daambien/scale-based-midi-controller/kicad/kb_pcb.kicad_pcb

## KiCad design kicad/kb_pcb.kicad_pcb (2022-11-20)

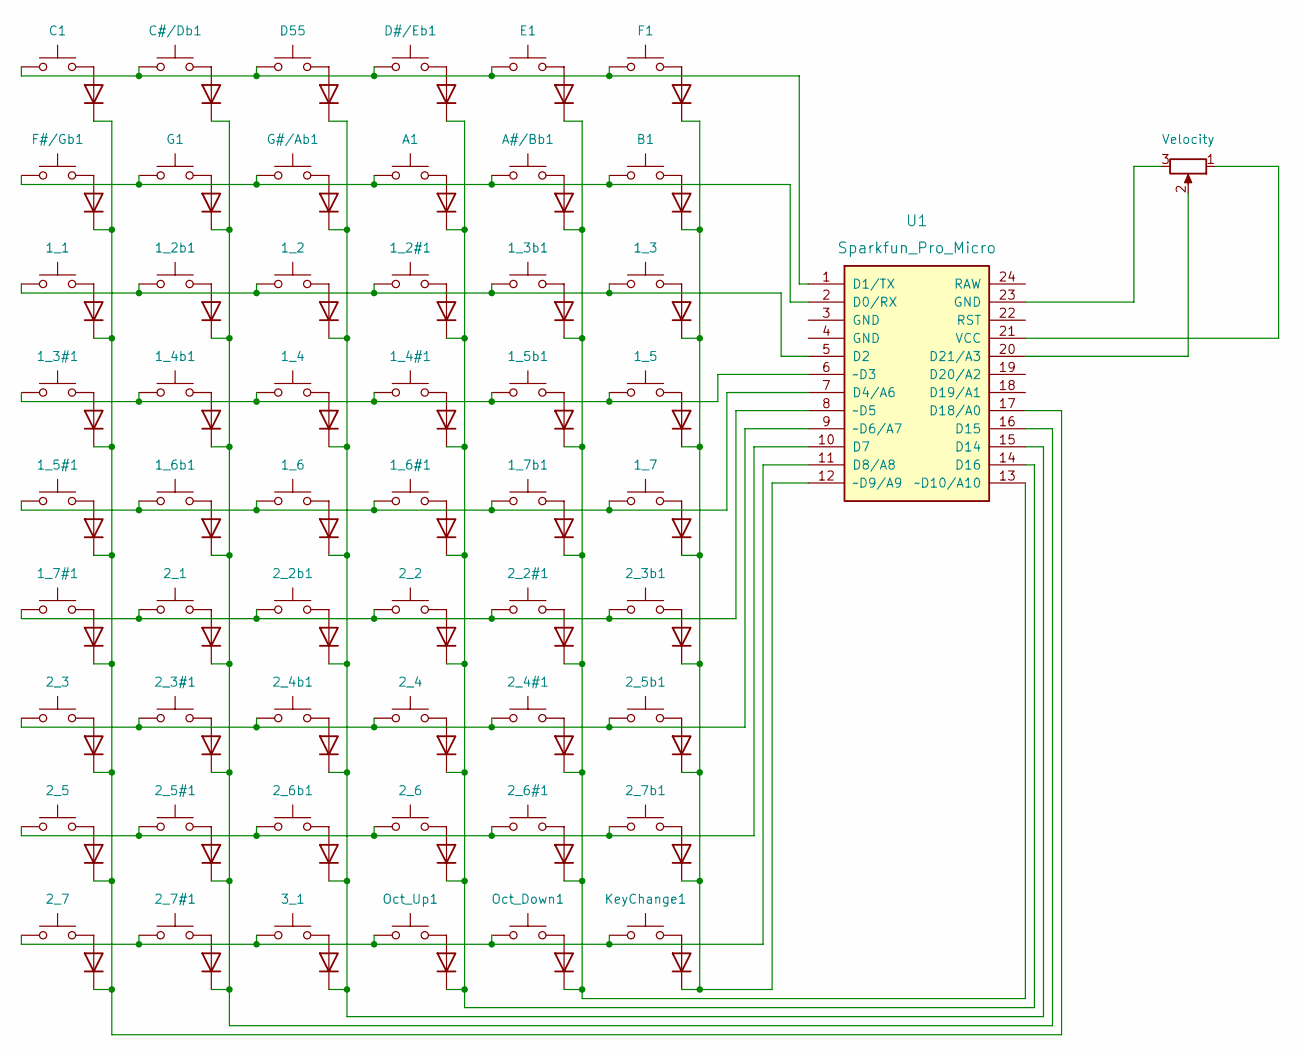
[picture p1: schematic kb_pcb.kicad_sch, MIDI_Keyboard]

Parts:
1_1, 1_2, 1_2#1, 1_2b1, 1_3, 1_3#1, 1_3b1, 1_4, 1_4#1, 1_4b1, 1_5, 1_5#1, 1_5b1, 1_6, 1_6#1, 1_6b1, 1_7, 1_7#1, 1_7b1, 2_1, 2_2, 2_2#1, 2_2b1, 2_3, 2_3#1, 2_3b1, 2_4, 2_4#1, 2_4b1, 2_5, 2_5#1, 2_5b1, 2_6, 2_6#1, 2_6b1, 2_7, 2_7#1, 2_7b1, 3_1: SW_Push; SW_Cherry_MX_1.00u_Plate
A1: SW_Push; SW_Cherry_MX_1.00u_Plate
A#/Bb1: SW_Push; SW_Cherry_MX_1.00u_Plate
B1: SW_Push; SW_Cherry_MX_1.00u_Plate
C1: SW_Push; SW_Cherry_MX_1.00u_Plate
C#/Db1: SW_Push; SW_Cherry_MX_1.00u_Plate
D1, D2, D3, D4, D5, D6, D7, D8, D9, D10, D11, D12, D13, D14, D15, D16, D17, D18, D19, D20, D21, D22, D23, D24, D25, D26, D27, D28, D29, D30, D31, D32, D33, D34, D35, D36, D37, D38, D39, D40, D41, D42, D43, D44, D45, D46, D47, D48, D49, D50, D51, D52, D53, D54: 1N4148; D_DO-35_SOD27_P7.62mm_Horizontal
D55: SW_Push; SW_Cherry_MX_1.00u_Plate
D#/Eb1: SW_Push; SW_Cherry_MX_1.00u_Plate
E1: SW_Push; SW_Cherry_MX_1.00u_Plate
F1: SW_Push; SW_Cherry_MX_1.00u_Plate
F#/Gb1: SW_Push; SW_Cherry_MX_1.00u_Plate
G1: SW_Push; SW_Cherry_MX_1.00u_Plate
G#/Ab1: SW_Push; SW_Cherry_MX_1.00u_Plate
KeyChange1: SW_Push; SW_Cherry_MX_1.00u_Plate
Oct_Down1: SW_Push; SW_Cherry_MX_1.00u_Plate
Oct_Up1: SW_Push; SW_Cherry_MX_1.00u_Plate
RV1: Velocity
U1: Sparkfun_Pro_Micro

Connections:
unnamed: 1_1.1, 1_2.1, 1_2#1.1, 1_2b1.1, 1_3.1, 1_3b1.1, U1.5 (D2)
unnamed: 1_1.2, D3.2 (A)
unnamed: 1_2#1.2, D30.2 (A)
unnamed: 1_2.2, D21.2 (A)
unnamed: 1_2b1.2, D12.2 (A)
unnamed: 1_3#1.1, 1_4.1, 1_4#1.1, 1_4b1.1, 1_5.1, 1_5b1.1, U1.6 (~D3)
unnamed: 1_3#1.2, D4.2 (A)
unnamed: 1_3.2, D48.2 (A)
unnamed: 1_3b1.2, D39.2 (A)
unnamed: 1_4#1.2, D31.2 (A)
unnamed: 1_4.2, D22.2 (A)
unnamed: 1_4b1.2, D13.2 (A)
unnamed: 1_5#1.1, 1_6.1, 1_6#1.1, 1_6b1.1, 1_7.1, 1_7b1.1, U1.7 (D4/A6)
unnamed: 1_5#1.2, D5.2 (A)
unnamed: 1_5.2, D49.2 (A)
unnamed: 1_5b1.2, D40.2 (A)
unnamed: 1_6#1.2, D32.2 (A)
unnamed: 1_6.2, D23.2 (A)
unnamed: 1_6b1.2, D14.2 (A)
unnamed: 1_7#1.1, 2_1.1, 2_2.1, 2_2#1.1, 2_2b1.1, 2_3b1.1, U1.8 (~D5)
unnamed: 1_7#1.2, D6.2 (A)
unnamed: 1_7.2, D50.2 (A)
unnamed: 1_7b1.2, D41.2 (A)
unnamed: 2_1.2, D15.2 (A)
unnamed: 2_2#1.2, D42.2 (A)
unnamed: 2_2.2, D33.2 (A)
unnamed: 2_2b1.2, D24.2 (A)
unnamed: 2_3.1, 2_3#1.1, 2_4.1, 2_4#1.1, 2_4b1.1, 2_5b1.1, U1.9 (~D6/A7)
unnamed: 2_3#1.2, D16.2 (A)
unnamed: 2_3.2, D7.2 (A)
unnamed: 2_3b1.2, D51.2 (A)
unnamed: 2_4#1.2, D43.2 (A)
unnamed: 2_4.2, D34.2 (A)
unnamed: 2_4b1.2, D25.2 (A)
unnamed: 2_5.1, 2_5#1.1, 2_6.1, 2_6#1.1, 2_6b1.1, 2_7b1.1, U1.10 (D7)
unnamed: 2_5#1.2, D17.2 (A)
unnamed: 2_5.2, D8.2 (A)
unnamed: 2_5b1.2, D52.2 (A)
unnamed: 2_6#1.2, D44.2 (A)
unnamed: 2_6.2, D35.2 (A)
unnamed: 2_6b1.2, D26.2 (A)
unnamed: 2_7#1.2, D18.2 (A)
unnamed: 2_7.2, D9.2 (A)
unnamed: 2_7b1.2, D53.2 (A)
unnamed: 2_7.1, 2_7#1.1, 3_1.1, KeyChange1.1, Oct_Down1.1, Oct_Up1.1, U1.11 (D8/A8)
unnamed: 3_1.2, D27.2 (A)
unnamed: A1.2, D29.2 (A)
unnamed: A1.1, A#/Bb1.1, B1.1, F#/Gb1.1, G1.1, G#/Ab1.1, U1.2 (D0/RX)
unnamed: A#/Bb1.2, D38.2 (A)
unnamed: B1.2, D47.2 (A)
unnamed: C1.2, D1.2 (A)
unnamed: C1.1, C#/Db1.1, D55.1, D#/Eb1.1, E1.1, F1.1, U1.1 (D1/TX)
unnamed: C#/Db1.2, D10.2 (A)
unnamed: D1.1 (K), D2.1 (K), D3.1 (K), D4.1 (K), D5.1 (K), D6.1 (K), D7.1 (K), D8.1 (K), D9.1 (K), U1.17 (D18/A0)
unnamed: D10.1 (K), D11.1 (K), D12.1 (K), D13.1 (K), D14.1 (K), D15.1 (K), D16.1 (K), D17.1 (K), D18.1 (K), U1.16 (D15)
unnamed: D19.1 (K), D20.1 (K), D21.1 (K), D22.1 (K), D23.1 (K), D24.1 (K), D25.1 (K), D26.1 (K), D27.1 (K), U1.15 (D14)
unnamed: D28.1 (K), D29.1 (K), D30.1 (K), D31.1 (K), D32.1 (K), D33.1 (K), D34.1 (K), D35.1 (K), D36.1 (K), U1.14 (D16)
unnamed: D37.1 (K), D38.1 (K), D39.1 (K), D40.1 (K), D41.1 (K), D42.1 (K), D43.1 (K), D44.1 (K), D45.1 (K), U1.13 (~D10/A10)
unnamed: D46.1 (K), D47.1 (K), D48.1 (K), D49.1 (K), D50.1 (K), D51.1 (K), D52.1 (K), D53.1 (K), D54.1 (K), U1.12 (~D9/A9)
unnamed: D19.2 (A), D55.2
unnamed: D28.2 (A), D#/Eb1.2
unnamed: D37.2 (A), E1.2
unnamed: D46.2 (A), F1.2
unnamed: D2.2 (A), F#/Gb1.2
unnamed: D11.2 (A), G1.2
unnamed: D20.2 (A), G#/Ab1.2
unnamed: D54.2 (A), KeyChange1.2
unnamed: D45.2 (A), Oct_Down1.2
unnamed: D36.2 (A), Oct_Up1.2
unnamed: RV1.1, U1.21 (VCC)
unnamed: RV1.2, U1.20 (D21/A3)
unnamed: RV1.3, U1.23 (GND)

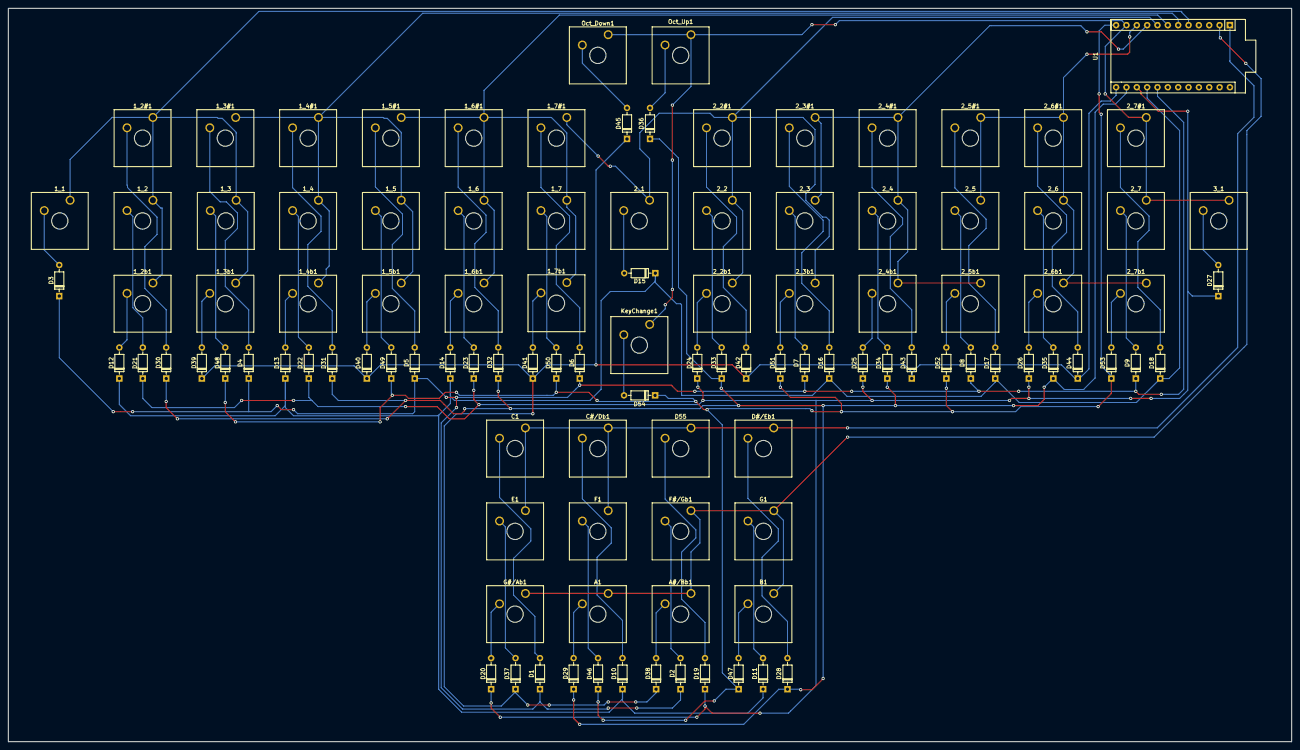
[picture p2: board kb_pcb.kicad_pcb from above]

Board: 2 copper layers, 315.0 x 180.0 mm, 109 parts (0 on the bottom side), 69 nets.
