daambien/scale-based-midi-controller/(commit log)

2022-11-20 Initial Commit
    Just all of the files I've been working on locally.
    [kb_pcb-B_Cu.gbl, kb_pcb-B_Mask.gbs, kb_pcb-B_Paste.gbp, kb_pcb-B_Silkscreen.gbo, kb_pcb-Edge_Cuts.gm1, kb_pcb-F_Cu.gtl, kb_pcb-F_Mask.gts, kb_pcb-F_Paste.gtp]
2022-11-24 Added pitch bend soft pot
